chucks13/LED-swarm/README.md

# LED-swarm
Arduino based radio synced addressable LEDstrips
