chucks13/LED-swarm/swarm/swarm.brd

## EAGLE design swarm/swarm.brd (2018-11-30)

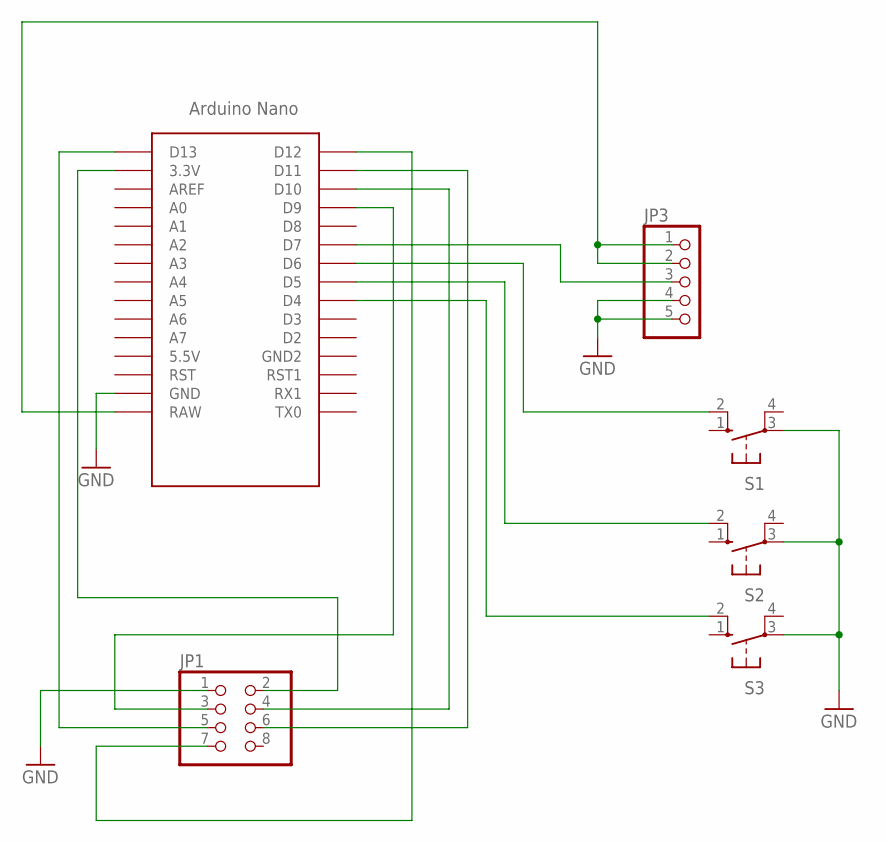
[picture p1: schematic swarm.sch]

Parts:
JP1: PINHD-2X4; 2X04
JP3: PINHD-1X5; 1X05
S1, S2, S3: 10-XX; B3F-10XX
U$1: NANO

Connections:
GND: JP1.1, JP3.4, JP3.5, S1.3, S2.3, S3.3, U$1.GND
unnamed: JP3.3, U$1.D7
unnamed: JP3.1, JP3.2, U$1.RAW
unnamed: S1.2 (S1), U$1.D6
unnamed: JP1.7, U$1.D12
unnamed: JP1.5, U$1.D13
unnamed: JP1.3, U$1.D9
unnamed: JP1.6, U$1.D11
unnamed: JP1.4, U$1.D10
unnamed: JP1.2, U$1.3.3V
unnamed: S2.2 (S1), U$1.D5
unnamed: S3.2 (S1), U$1.D4

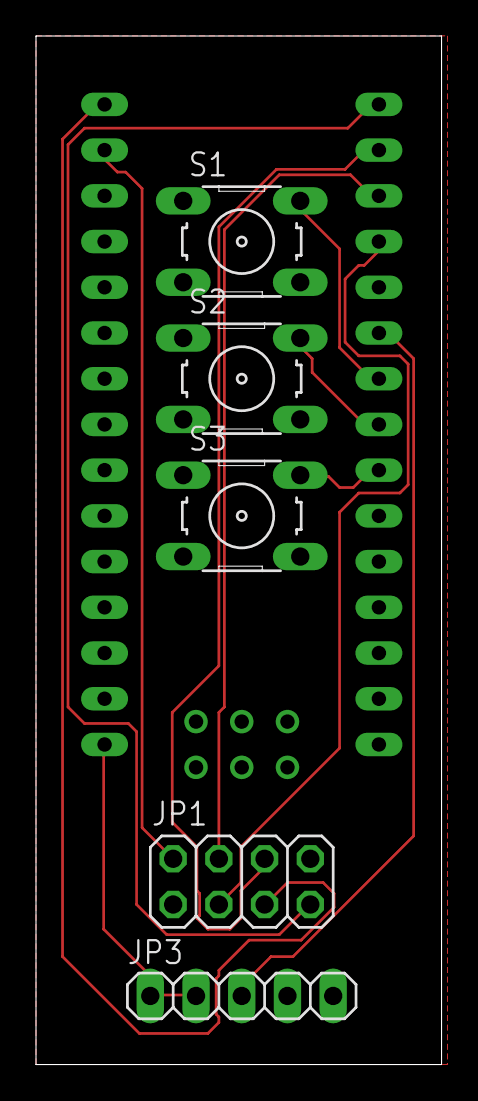
[picture p2: board swarm.brd from above]

Board: 2 copper layers, 22.5 x 57.1 mm, 6 parts (0 on the bottom side), 12 nets.
