chucks13/LED-swarm/todo.txt

Create schematics

Make PC boards

Make more effects
