chucks13/LED-swarm/(threads)

Thread 1 (2019-06-13):

Thank you for FOSSing - planning to adapt for project

100ideas, 2019-06-13:
Hi Chuck,

This is an awesome project; thank you for sharing it and especially for sharing the code and board pcb fab files!

I am working on some wearable capes for my crew this year and have been looking into ways to wirelessly trigger effects when we are in a group.

Besides your project, I've been considering the [electromage pixelblaze](https://www.bhencke.com/pixelblazegettingstarted) + firestorm server, which is an APA102 driver based on an esp8266 chip which provides wifi connectivity. It seems primarily designed for static installations but it *might* be robust enough for wearables that wander in/out of range - not sure, I will do some testing this summer.

I said hi over on your [LEDs ARE AWESOME](https://www.facebook.com/groups/LEDSAREAWESOME/permalink/1046179785577480/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) video post but I thought it might be nice to open this issue here as well if I can provide any informal documentation or notes for posterity while I try to replicate your sw/hw.

I ordered some pcbs based on the design in the repo (last updated 6 mo ago) for testing and then noticed your comment that they were out of date. That's ok, I'll figure it out; but if you could provide any details about hidden bugs you've fixed or important updates you've made in the unpublished code I'd appreciate it. I'll post my updates here.

100ideas, 2019-06-19:
We are keeping project notes for our adaptation of led-swarm here fyi https://hackmd.io/@100ideas/scarfswarm

later on we'll get it all on github.

Thread 2 (2019-06-19):

Swarm II pcb bug list

100ideas, 2019-06-19:
On facebook Chuck mentioned several minor bugs in the "Swarm II" board. This issue is for tracking those bugs and any progress made fixing them.

> Look int0 the swarm folder now. There is a file called swarm3.zip, which I have been calling the Swarm II board. If you are talented in eagle...

- [ ] I ask you to correct the wiring of the radio pins, and find a way to add a vcut so the board can be easily broken apart.

- [ ] Also, the radio should be shifted a pin to the right, so it is right justified with the Teensy board. That will make the radio crystal clear the printed tube assembly bettter.

- [ ] Another improvement would be holes for an optional capacitor like the one suggest in many of the NFR24L01 projects.

Thread 3 (2019-06-21):

bug w/ pushbutton: int overlfow, BUTTONUP should be 1

100ideas, 2019-06-21:
I built 2 test systems (nano + 60 ws2811) so I could play around with your code. While implementing a strobe function I noticed the code for triggering functions from button-presses wasn't working as expected.

The push button is connected to a pin configured w/ `INPUT_PULLUP` but the code that checks the button pin thinks `BUTTONUP = 0` which is the opposite of what the pullup mode does.

The same code checks if `buttonDownTime` (an `int`) is > 50000 microseconds to determine if the button press was a short press. But max value for `int` is usually 32767, so the button events never trigger.

I'll upload my code to a fork later but in the meantime here's what I changed (starting from around line 192 in led_swarm_3.ino):

```
// BUG sized int max value is 32767 but BUTTONSHORTTIME is 50000 - so use long
// int buttonDownTime;                                 // for measuring button presses
unsigned long buttonDownTime;                                 // for measuring button presses

char buttonState;                                   // is the button up or down
char buttonEvent;                                   // what the button did (short,long)
char radioEvent = 0;                                // what the radio

// BUG (potentially) will cause problems if LEDPERIOD value is ever larger than INT
//   (unless on Due?) int is too small use long
int timeToDisplay;                                  // how long to update the display
// long timeToDisplay;                                  // how long to update the display
```
