chucks13/LED-swarm/(commit log)

2018-11-30 Add files via upload
    board design
    [swarm.brd, swarm.sch]
2018-12-13 Add files via upload
    added accelerator connector
    [swarm.sch]
2019-05-05 Added STL files
    Added STL files
2019-05-25 timing update
    changed master/slave to leader/follower, changed millis() to micro(), Changed effect timeout to count up instead of down
2019-05-25 Delete led_swarm.ino
    out of date
2019-06-15 Fixed some master timing
    fixed timeouts, and added a define for the strongman effect number which has changed from 10 to 200
    [SyncedAnims.h, led_swarm_3.ino]
2019-06-16 First draft of rev 2 swarm board wand assembly
    Probably has spelling errors.
2019-06-18 Assembly instructions in 3 parts
    splitting the instructions into 3 pdf files seems to make all the pictures show up
2019-06-19 swarm 3 board for teensy
    This board has an error on it. The analog pins were used for the radio instead of the digital pins.
